baobuibk/SATELITTE_LASER_HW_1.0.0/01_DESIGN/Block_V2_Detail-LASER_DETAIL.png

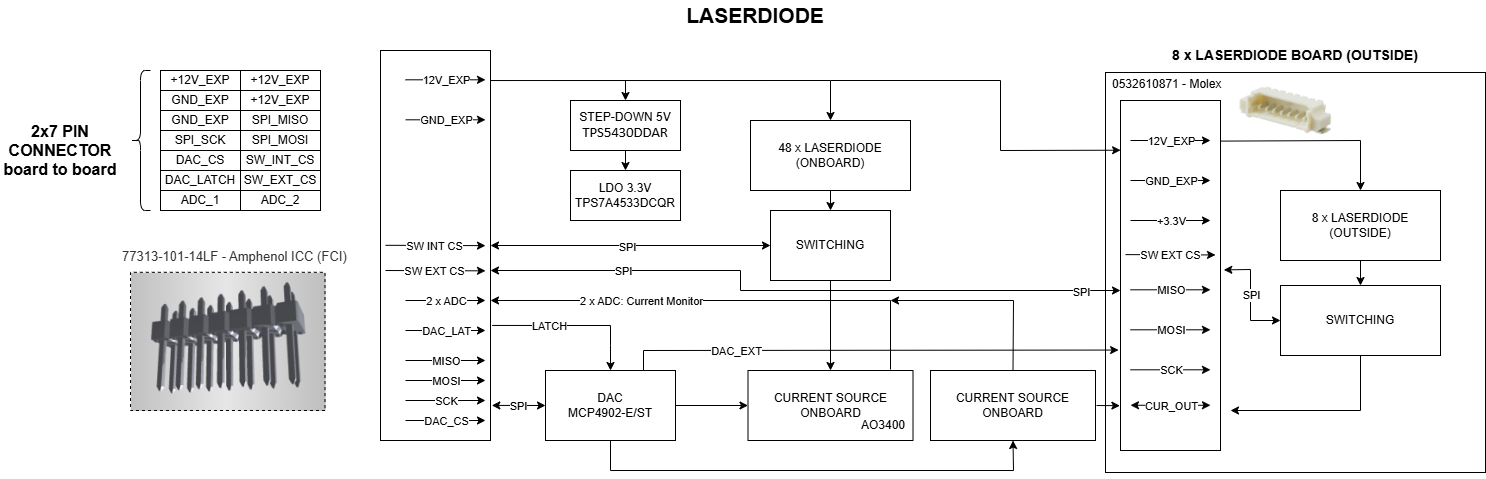
01_DESIGN/Block_V2_Detail-LASER_DETAIL.png
