baobuibk/SATELITTE_LASER_HW_1.0.0/03_BOM/NANORACK_LASER.xlsx

Name | Description | Designator | Footprint | Manufacturer 1 | Manufacturer Part Number 1 | Quantity | NOTE | STATUS
10nF/16V | CL10B103KB8NNNC | C1 | SM-0603 | Samsung Electro-Mechanics | CL10B103KB8NNNC | 1 |  | STOCK
0.22uF/25V | CL10B224KA8NNNC | C2, C3, C9, C10, C11, C12, C17, C18, C20, C21, C24, C25, C26, C30, C33, C34, C35, C36, C37, C38, C39, C40, C43, C44, C46, C47, C53, C54, C55, C56, C59, C60, C61, C62, C63, C64 | SM-0603 | Samsung Electro-Mechanics | CL10B224KA8NNNC | 36 |  | STOCK
47uF/20V | TAJC476K020RNJ | C4, C5, C6, C7, C8, C13, C14, C15, C16 | CAP TANT 2312 | KYOCERA AVX | TAJC476K020RNJ | 9 |  | ORDER
470pF/50V | CL10B471KB8NNNC | C19, C23, C27, C28, C29, C48, C49, C50 | SM-0603 | Samsung Electro-Mechanics | CL10B471KB8NNNC | 8 |  | STOCK
12pF/50V | CL10C120JB81PNC | C22, C32, C42, C45, C52, C58 | SM-0603 | Samsung Electro-Mechanics | CL10C120JB81PNC | 6 |  | STOCK
100pF/25V | C0603C101M3HACTU | C31, C41, C51, C57 | SM-0603 | KEMET | C0603C101M3HACTU | 4 |  | ORDER
SS54 | SS54 | D1 | DIO-SMD-A | Multicomp | SS54 | 1 |  | STOCK
S2303 | S2303 | D2, D3, D4, D5, D6, D7, D8, D9 | SOT23-123 | SMC Diode Solutions | S2303 | 8 |  | STOCK
1N4148W-TP | 1N4148W-TP | D10, D11, D12, D13, D14, D15, D16, D17, D18, D19, D20, D21, D22, D23, D24, D25, D26, D27, D28, D29, D30, D31, D32, D33 | SOD23 | Micro Commercial Co | 1N4148W-TP | 24 |  | STOCK
532611171 | 532611171 | J2 | MOLEX_532611171 | Molex | 53261-1171 | 1 |  | ORDER
0510211100 | CONN RCPT HSG 11POS 1.25MM |  |  | Molex | 0510211100 | 1 | Mating for J2 | ORDER
532610871 | 532610871 | J3 | MOLEX_532610001 | Molex | 53261-0871 | 1 |  | STOCK
0510210800 | CONN RCPT HSG 8POS 1.25MM |  |  | Molex | 0510210800 | 1 | Mating for J3 | STOCK
0500798000 | CONN SOCKET 26-28AWG CRIMP TIN |  |  | Molex | 0500798000 | 19 | Cos for mating J2 & J3 | STOCK
15uH/3.5A | SRP7050TA-150M | L1 | SRP7050TA | Bourns | SRP7050TA-150M | 1 |  | STOCK
10uH | MLZ1608N100LT000 | L2 | FER 0805/2012 | TDK | MLZ1608N100LT000 | 1 |  | STOCK
LaserDiode | OPV302 | LD1, LD2, LD3, LD4, LD5, LD6, LD7, LD8, LD9, LD10, LD11, LD12, LD13, LD14, LD15, LD16, LD17, LD18, LD19, LD20, LD21, LD22, LD23, LD24 | LASER_SOCKET | Optek | OPV302 | 24 |  | STOCK
DMG302PU-7 | DMG302PU-7 | Q1, Q3 | SOT23-3-132 | Diodes Inc. | DMG302PU-7 | 2 |  | ORDER
DMG301NU-7 | DMG301NU-7 | Q2, Q4 | SOT23-3-132 | Diodes Inc. | DMG301NU-7 | 2 |  | ORDER
10K/1% | ERJ-3EKF1002V | R1 | RES-SMD-0603 | Panasonic | ERJ-3EKF1002V | 1 |  | STOCK
3.24K 0.1% | ERJ-3EKF3241V | R2 | RES-SMD-0603 | Panasonic | ERJ-3EKF3241V | 1 |  | STOCK
300R/0.1% | RT0603BRC07300RL | R3 | RES_SMD_0603_SHUNT | Yageo Group | RT0603BRC07300RL | 1 |  | ORDER
30K/0.1% | ERA-3AEB303V | R4, R21 | RES-SMD-0603 | Panasonic | ERA-3AEB303V | 2 |  | ORDER
51R/1% | ERJ-3EKF51R0V | R6, R17, R22, R31 | RES-SMD-0603 | Panasonic | ERJ-3EKF51R0V | 4 |  | STOCK
1K/1% | ERJ-3EKF1001V | R7, R8, R9, R15, R18, R19, R23, R24, R25, R29, R32, R33 | RES-SMD-0603 | Panasonic | ERJ-3EKF1001V | 12 |  | STOCK
100R/1% | ERJ-PA3D1000V | R10, R11, R14, R26, R27, R28 | RES-SMD-0603 | Panasonic | ERJ-PA3D1000V | 6 |  | ORDER
4.7K/1% | ERJ-3EKF4701V | R5, R12, R13, R34, R35, R36, R37, R38, R39 | RES-SMD-0603 | Panasonic | ERJ-3EKF4701V | 9 |  | STOCK
20K/0.1% | ERA-3AEB203V | R16, R30 | RES-SMD-0603 | Panasonic | ERA-3AEB203V | 2 |  | ORDER
75R/0.1% | TNPW060375R0BEEA | R20 | RES_SMD_0603_SHUNT | Vishay | TNPW060375R0BEEA | 1 |  | ORDER
TPS5430DDAR | TPS5430DDAR | U1 | HSOP8 | Texas Instruments | TPS5430DDAR | 1 |  | STOCK
TPS7A4533DCQR | TPS7A4533DCQR | U2 | SOT223-6 | Texas Instruments | TPS7A4533DCQR | 1 |  | STOCK
MCP4902-E/ST | MCP4902-E/ST | U3 | TSSOP14 | Microchip | MCP4902-E/ST | 1 |  | ORDER
INA139 | INA139NA/250 | U4, U6 | SOT23-5 | Texas Instruments | INA139NA/250 | 2 |  | ORDER
OPA2192 | OPA2192IDR | U5, U7 | SO8 | Texas Instruments | OPA2192IDR | 2 |  | ORDER
ADG1414BRUZ | ADG1414BRUZ | U8, U9, U10 | TSSOP24 | Analog Devices | ADG1414BRUZ | 3 |  | STOCK
Custom Socket Laser | CONN PIN RCPT .015-.022 SOLDER |  |  | Mill-Max Manufacturing Corp. | 0461-1-15-15-21-27-04-0 | 144 | Note:(4 x (24 + 12)) | STOCK
 |  |  |  |  | Total | 178
