baobuibk/SATELITTE_LASER_HW_1.0.0/02_SCHEMATIC_PDF/NANORACK_LASER_V130.pdf

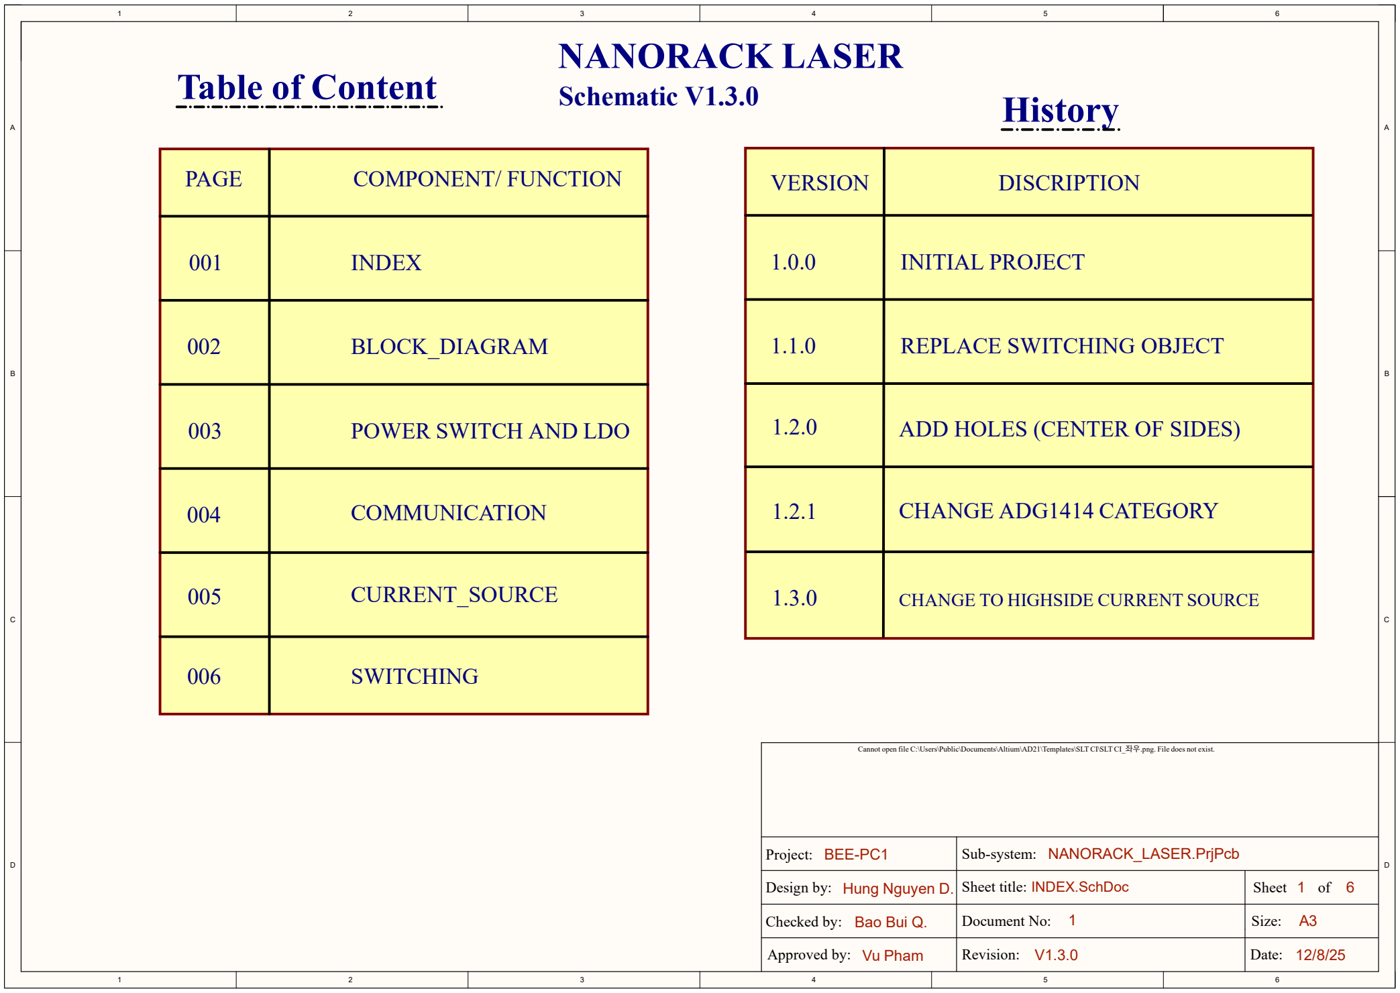
[picture p2: figure]
Table of Content; PAGE; COMPONENT/ FUNCTION; INDEX; BLOCK_DIAGRAM; POWER SWITCH AND LDO; COMMUNICATION; CURRENT_SOURCE; SWITCHING; NANORACK LASER; Schematic V1.3.0; History; VERSION; DISCRIPTION; INITIAL PROJECT; REPLACE SWITCHING OBJECT; 1.2.0 ADD HOLES (CENTER OF SIDES); 1.2.1 CHANGE ADG1414 CATEGORY; 1.3.0 CHANGE TO HIGHSIDE CURRENT SOURCE

Cannot open file C:\Users\Public\Documents\Altium\AD21\Templates\SLT CI\SLT CI_좌우.png. File does not exist.

Project: BEE-PC1 | Sub-system: NANORACK_LASER.PrjPcb
Design by: Hung Nguyen D. | Sheet title: INDEX.SchDoc | Sheet 1 6 of
Checked by: Bao Bui Q. | Document No: | Size: A3
Approved by: Vu Pham | Revision: V1.3.0 | Date: 12/8/25

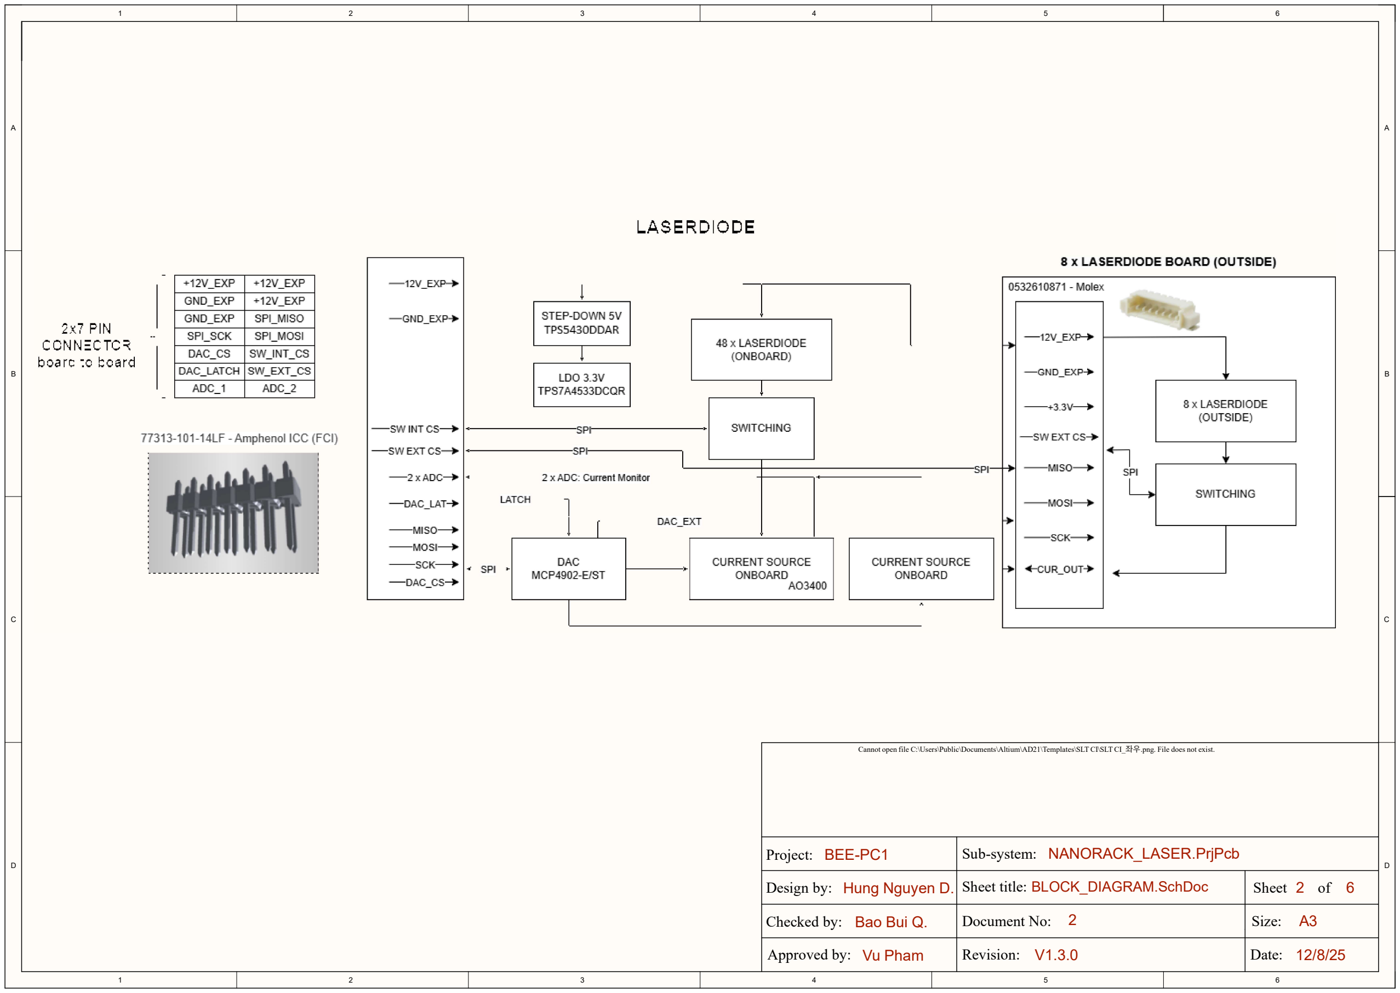
[picture p3: page 2]

D D

C C

B B

A A

# Date: 12/8/25

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

Project: BEE-PC1 | Sub-system: NANORACK_LASER.PrjPcb
Design by: Hung Nguyen D. | Sheet title: BLOCK_DIAGRAM.SchDoc | Sheet 2 6 of

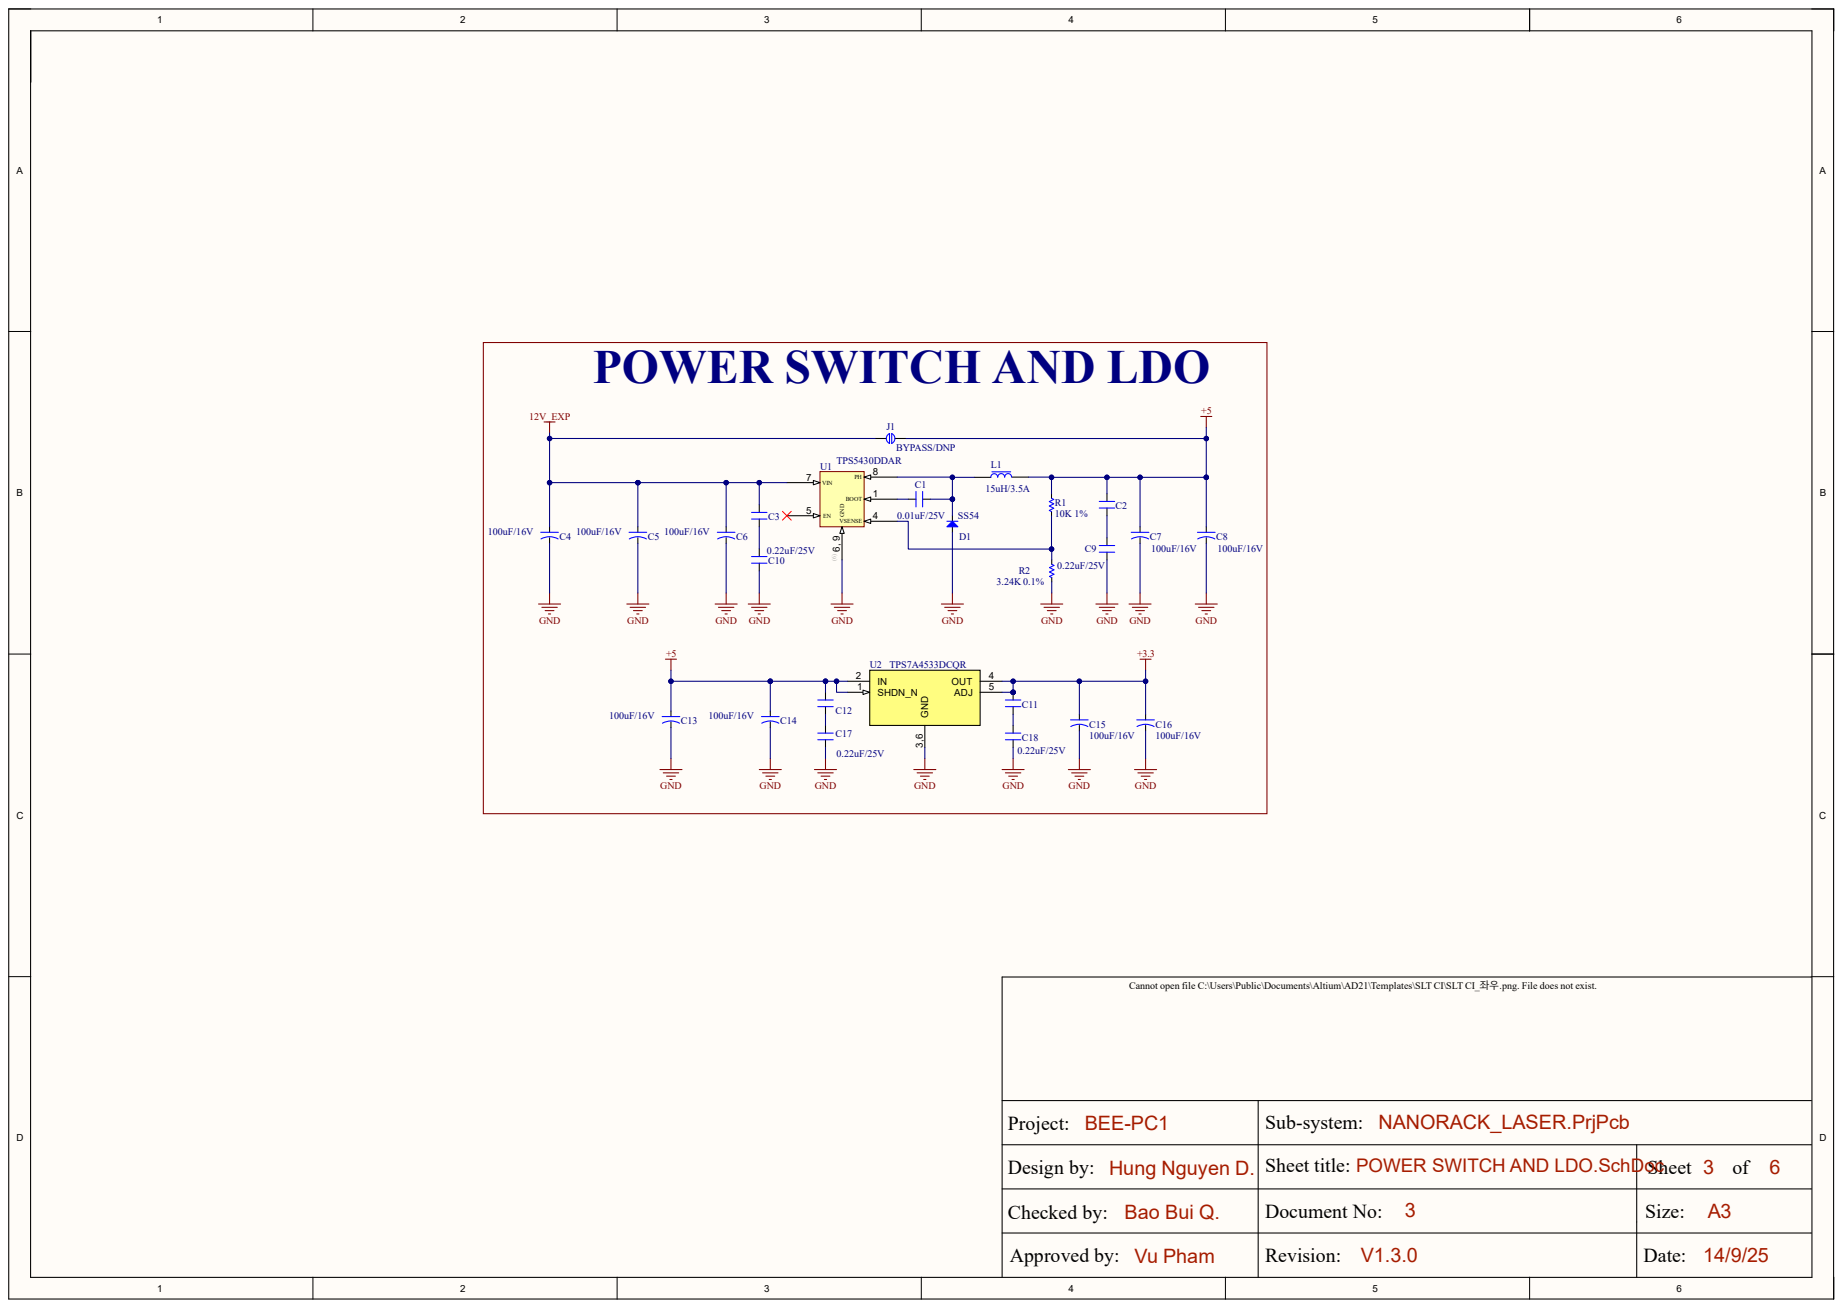
[picture p4: page 3]

POWER SWITCH AND LDO

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

Project: BEE-PC1 | Sub-system: NANORACK_LASER.PrjPcb

Design by: Hung Nguyen D. | Sheet title: POWER SWITCH AND LDO.SchDoc | Sheet 3 6 of

# BOARD TO BOARD CONNECTOR TO EXP BOARD

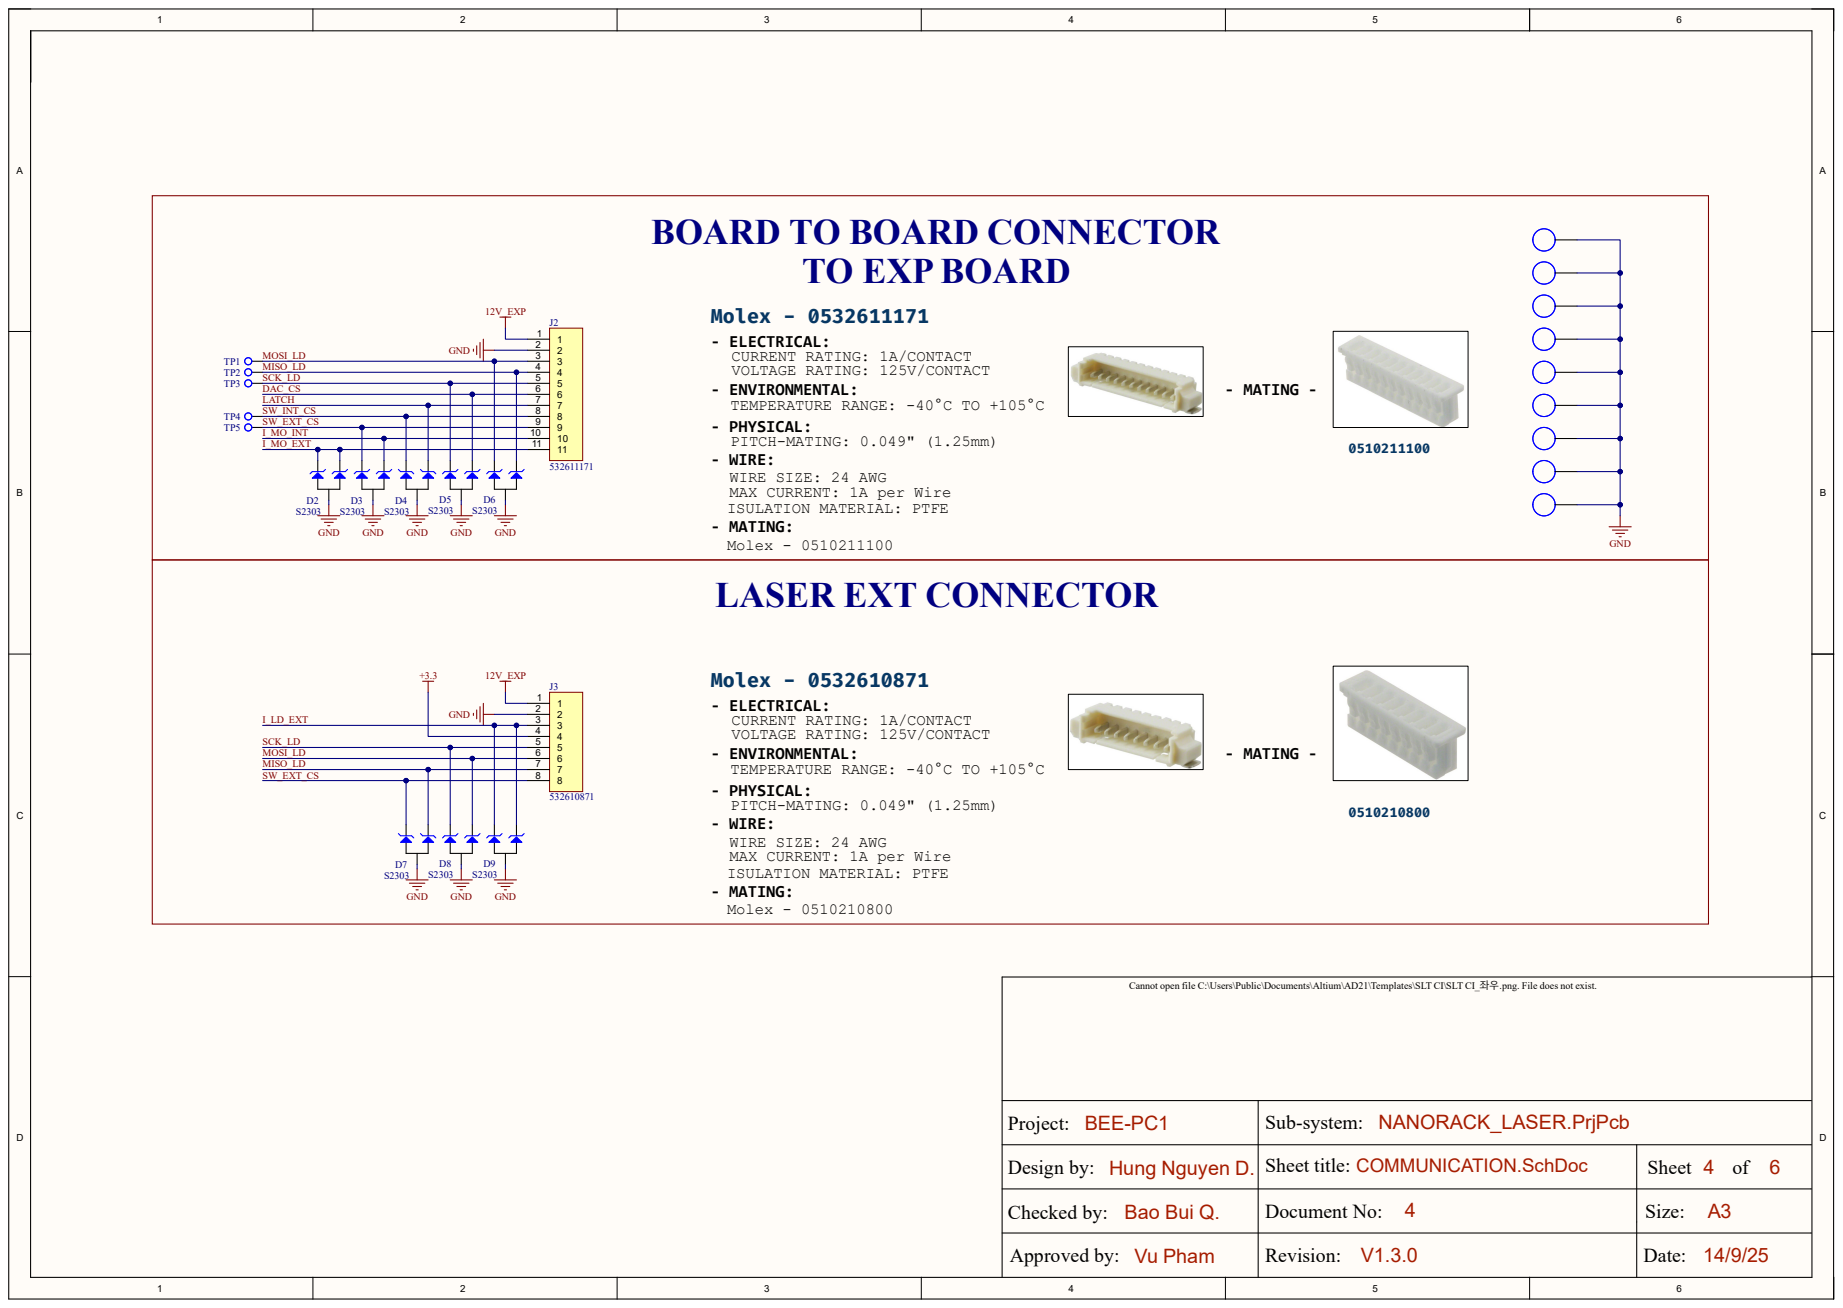
[picture p5: page 4]

Molex - 0532611171
- ELECTRICAL:
CURRENT RATING: 1A/CONTACT
VOLTAGE RATING: 125V/CONTACT
- ENVIRONMENTAL:
TEMPERATURE RANGE: -40°C TO +105°C
- PHYSICAL:
PITCH-MATING: 0.049" (1.25mm)
- WIRE:
WIRE SIZE: 24 AWG
MAX CURRENT: 1A per Wire
ISULATION MATERIAL: PTFE
- MATING:
LASER EXT CONNECTOR

Molex - 0532610871
Molex - 0510210800

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

Project: BEE-PC1 | Sub-system: NANORACK_LASER.PrjPcb

Design by: Hung Nguyen D. | Sheet title: COMMUNICATION.SchDoc | Sheet 4 6 of

# DRIVER_INT

# I_LDmax = 30mA, Choose VDACmax = 3V -> R8 = 100R

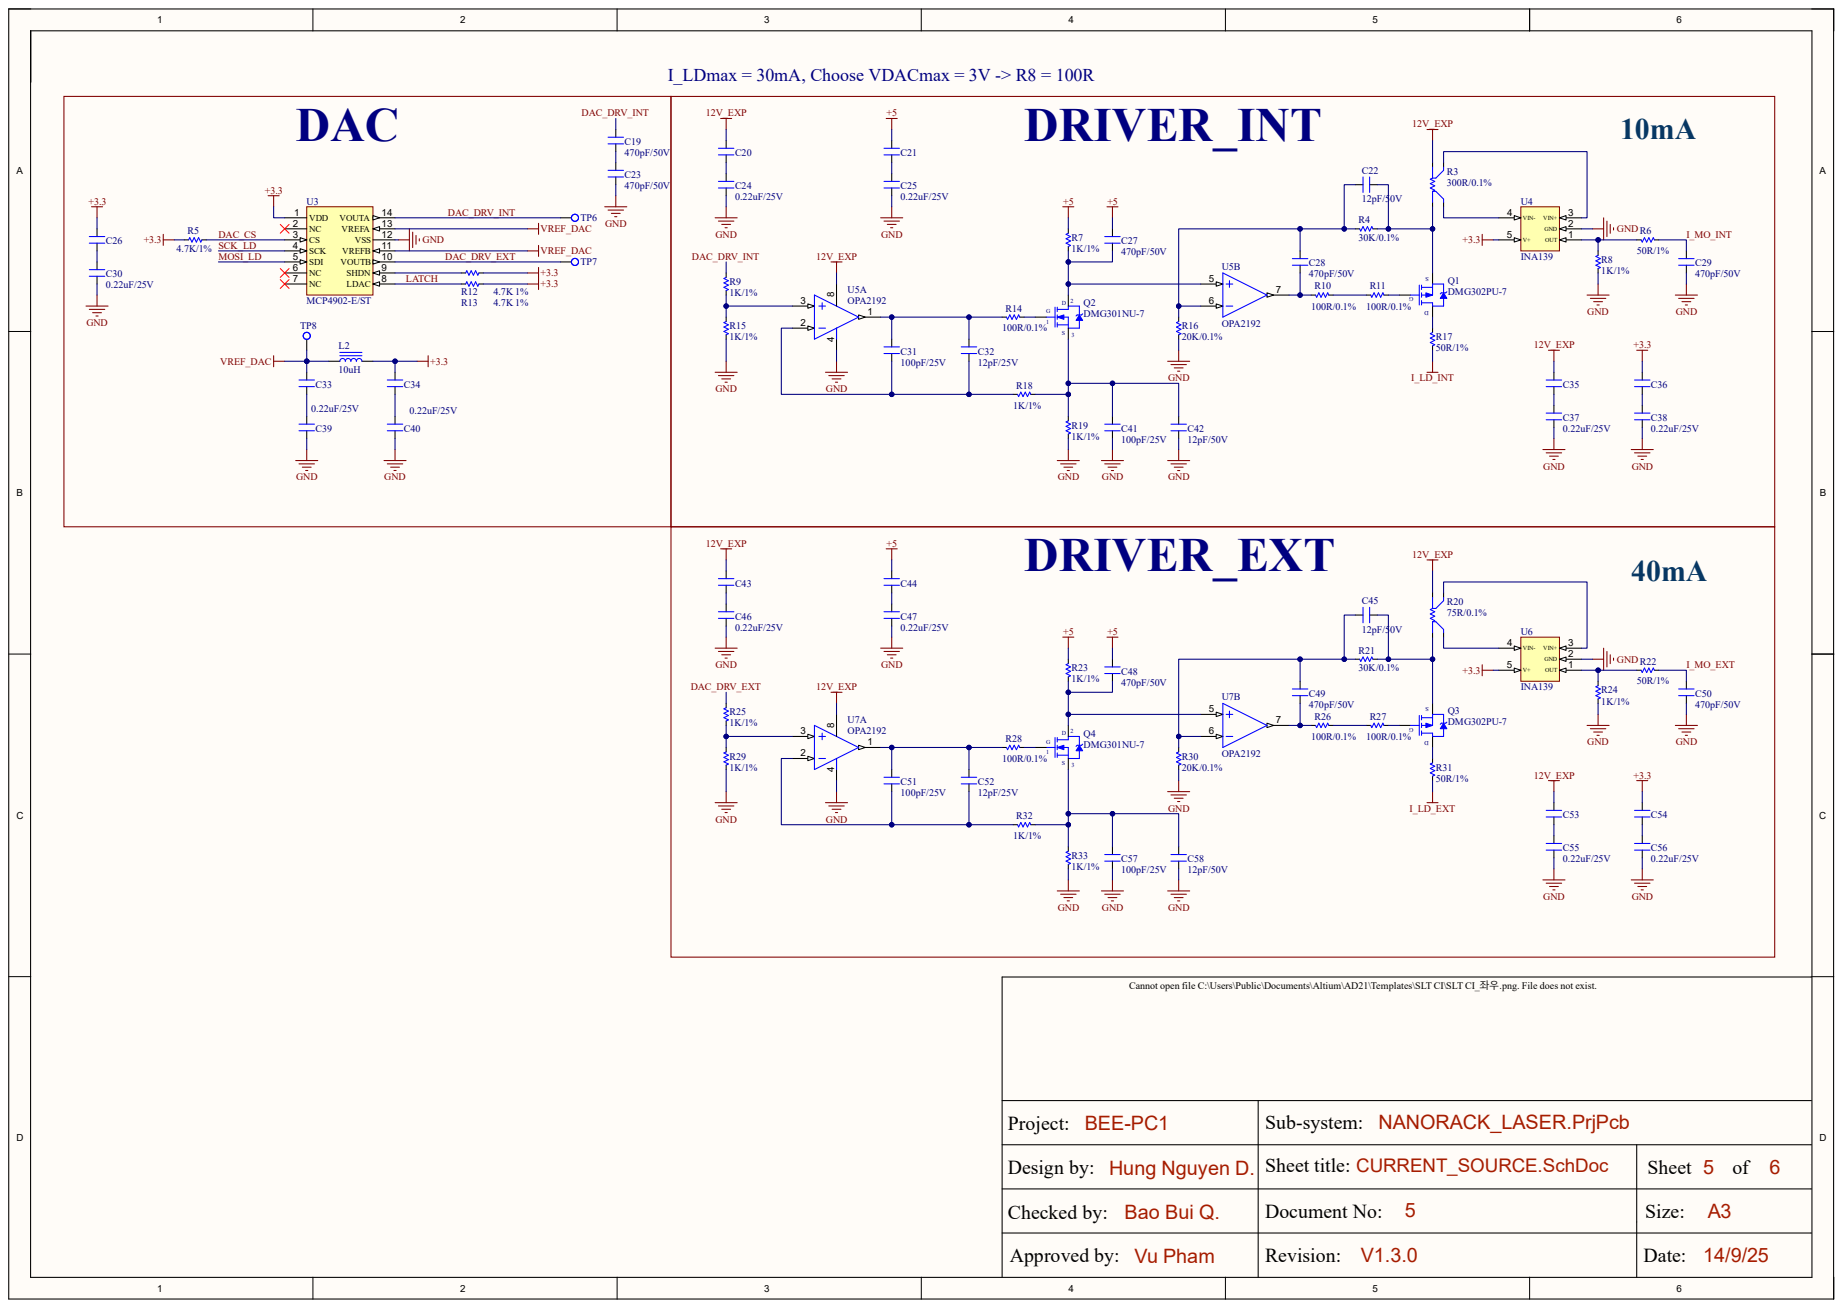
[picture p6: page 5]

VOUTB 10 VREFB 11 VSS 12 VREFA 13 VOUTA 14

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

Project: BEE-PC1 | Sub-system: NANORACK_LASER.PrjPcb

Design by: Hung Nguyen D. | Sheet title: CURRENT_SOURCE.SchDoc | Sheet 5 6 of

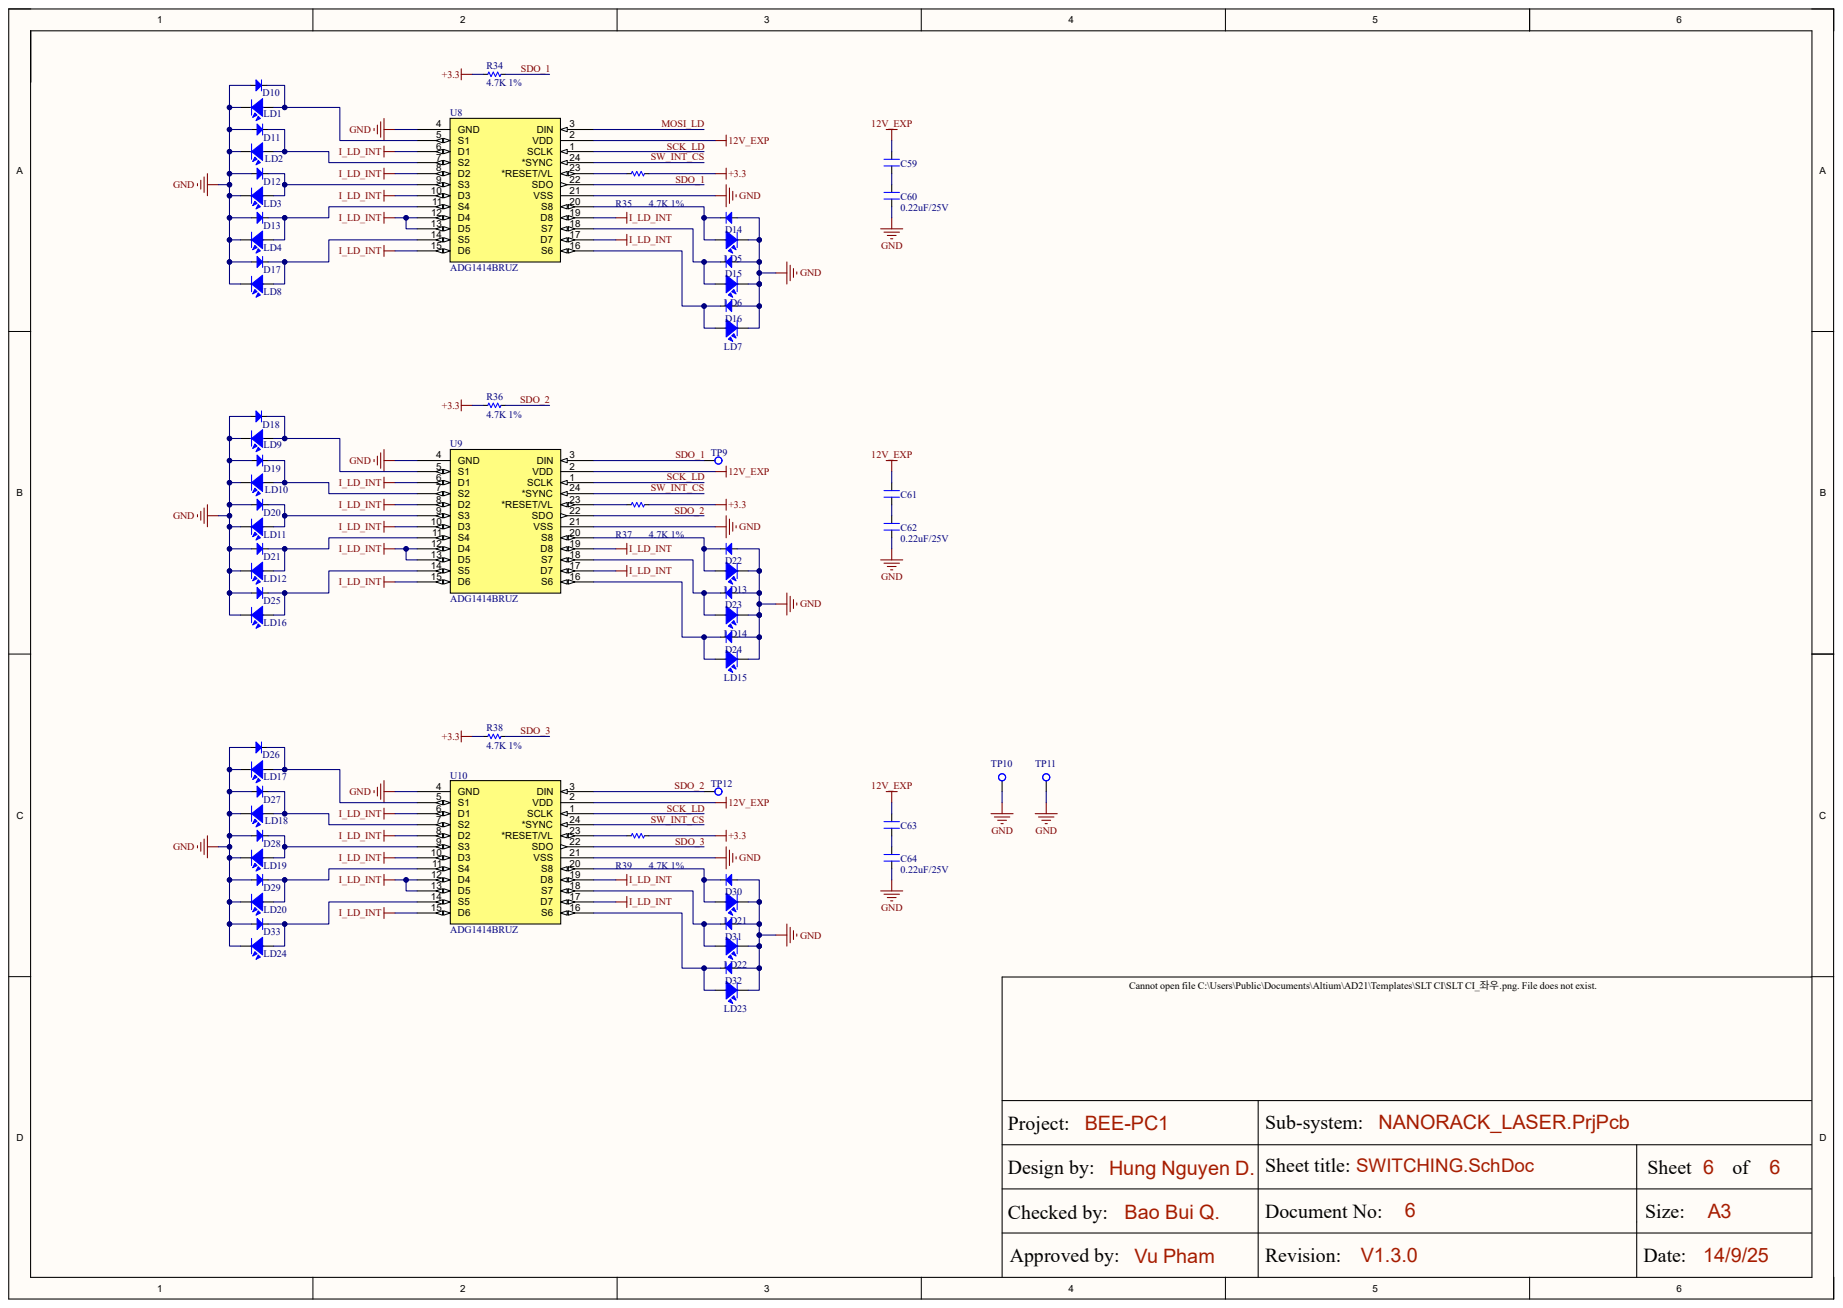
[picture p7: page 6]
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

Project: BEE-PC1 | Sub-system: NANORACK_LASER.PrjPcb

Design by: Hung Nguyen D. | Sheet title: SWITCHING.SchDoc | Sheet 6 6 of
