baobuibk/SATELITTE_LASER_HW_1.0.0/05_SMT/ASM_NANORACK_LASER_V130.pdf

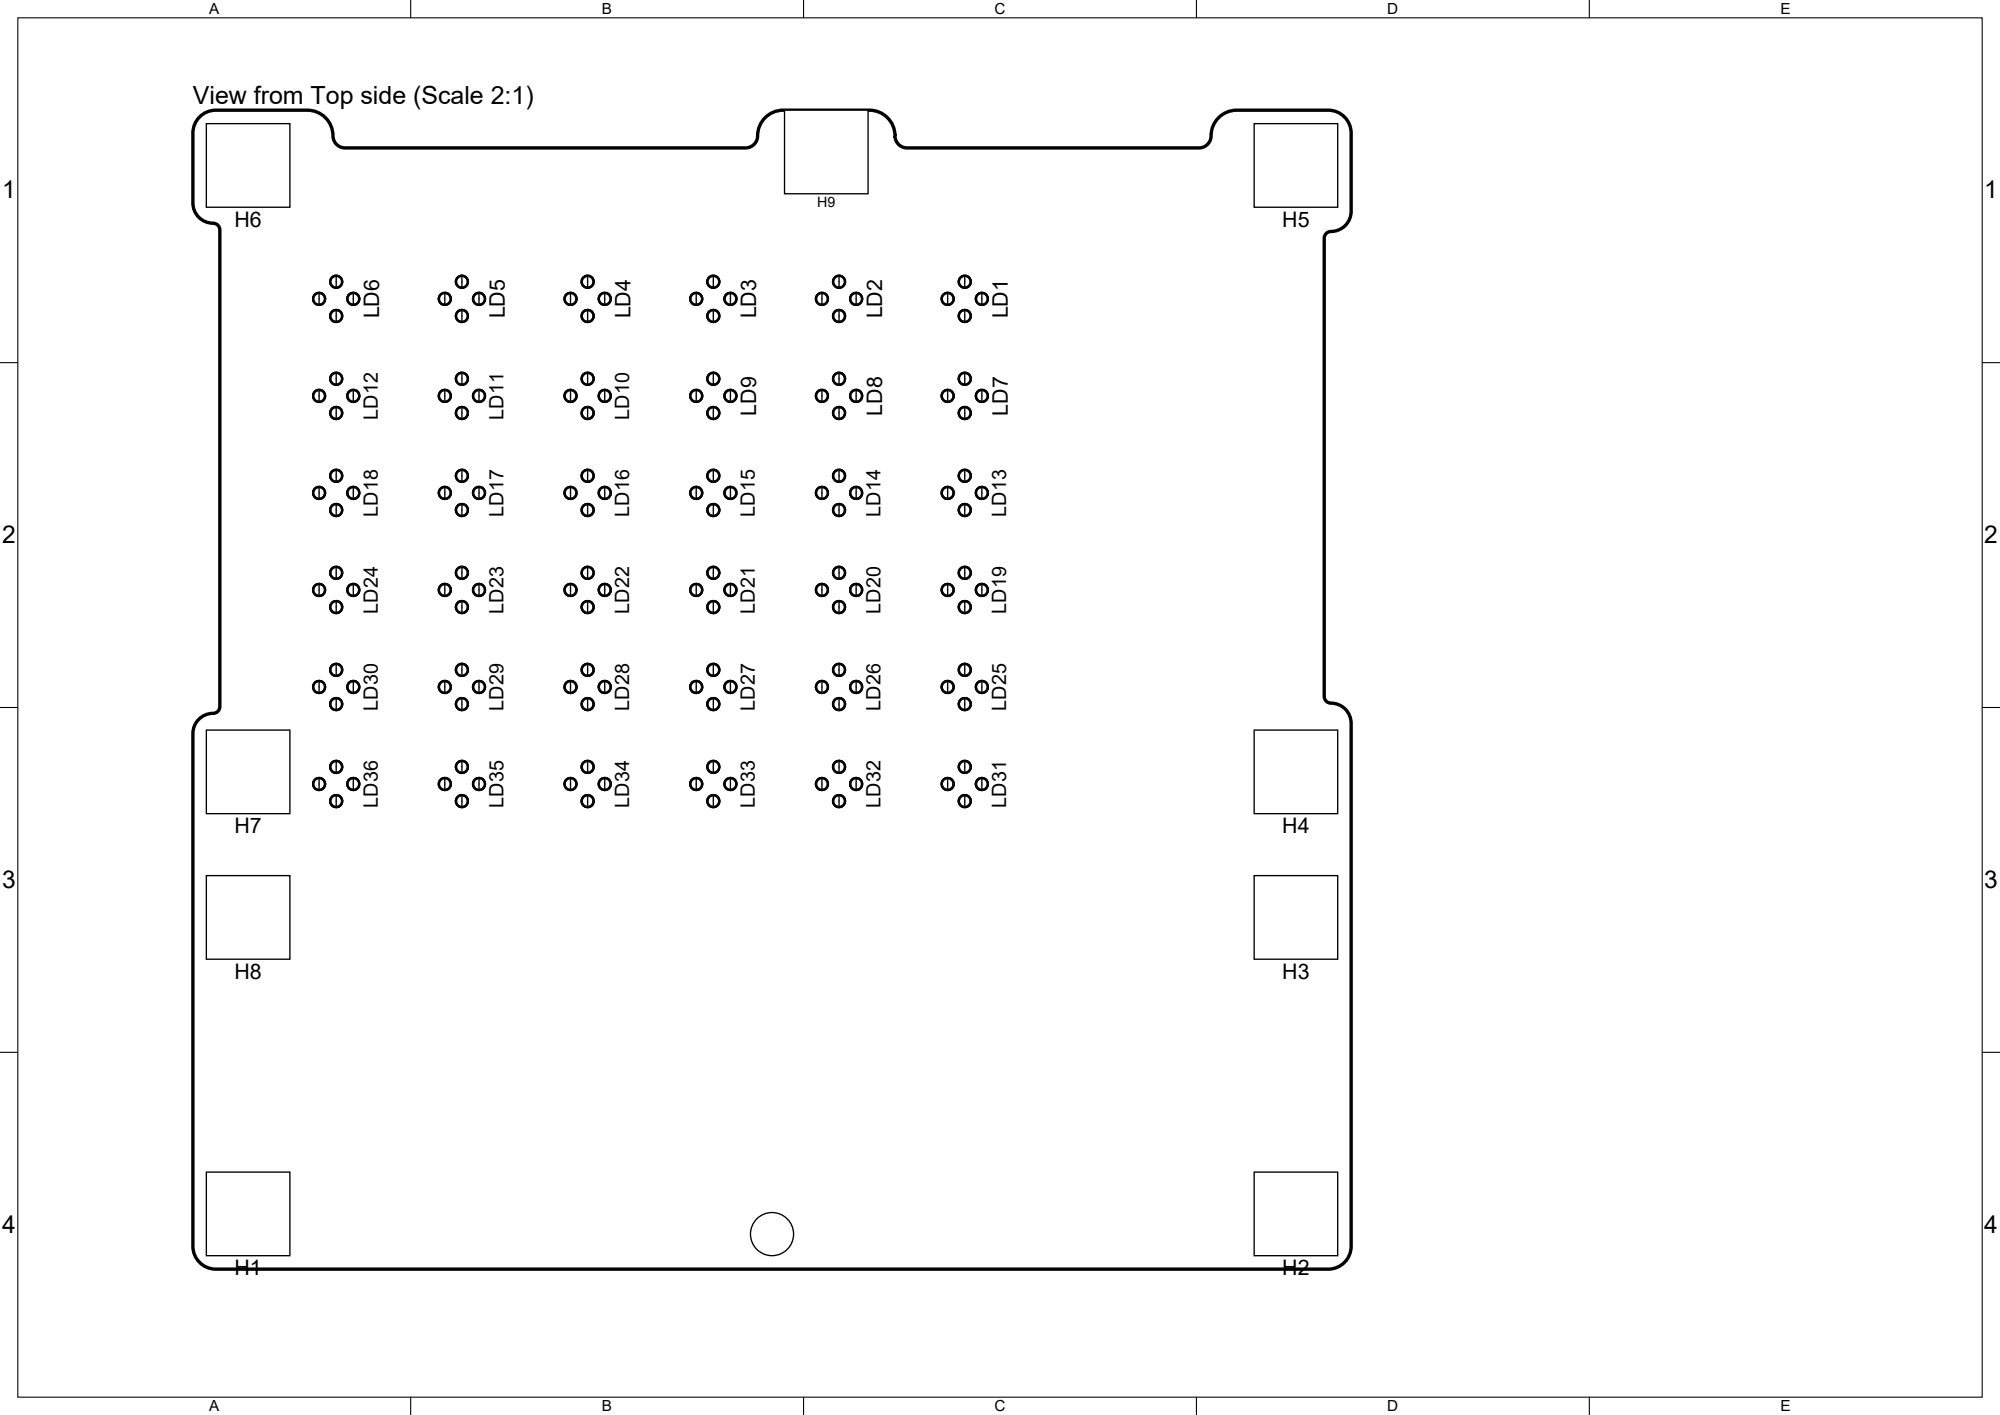
[picture p8: page 1]

View from Top side (Scale 2:1)

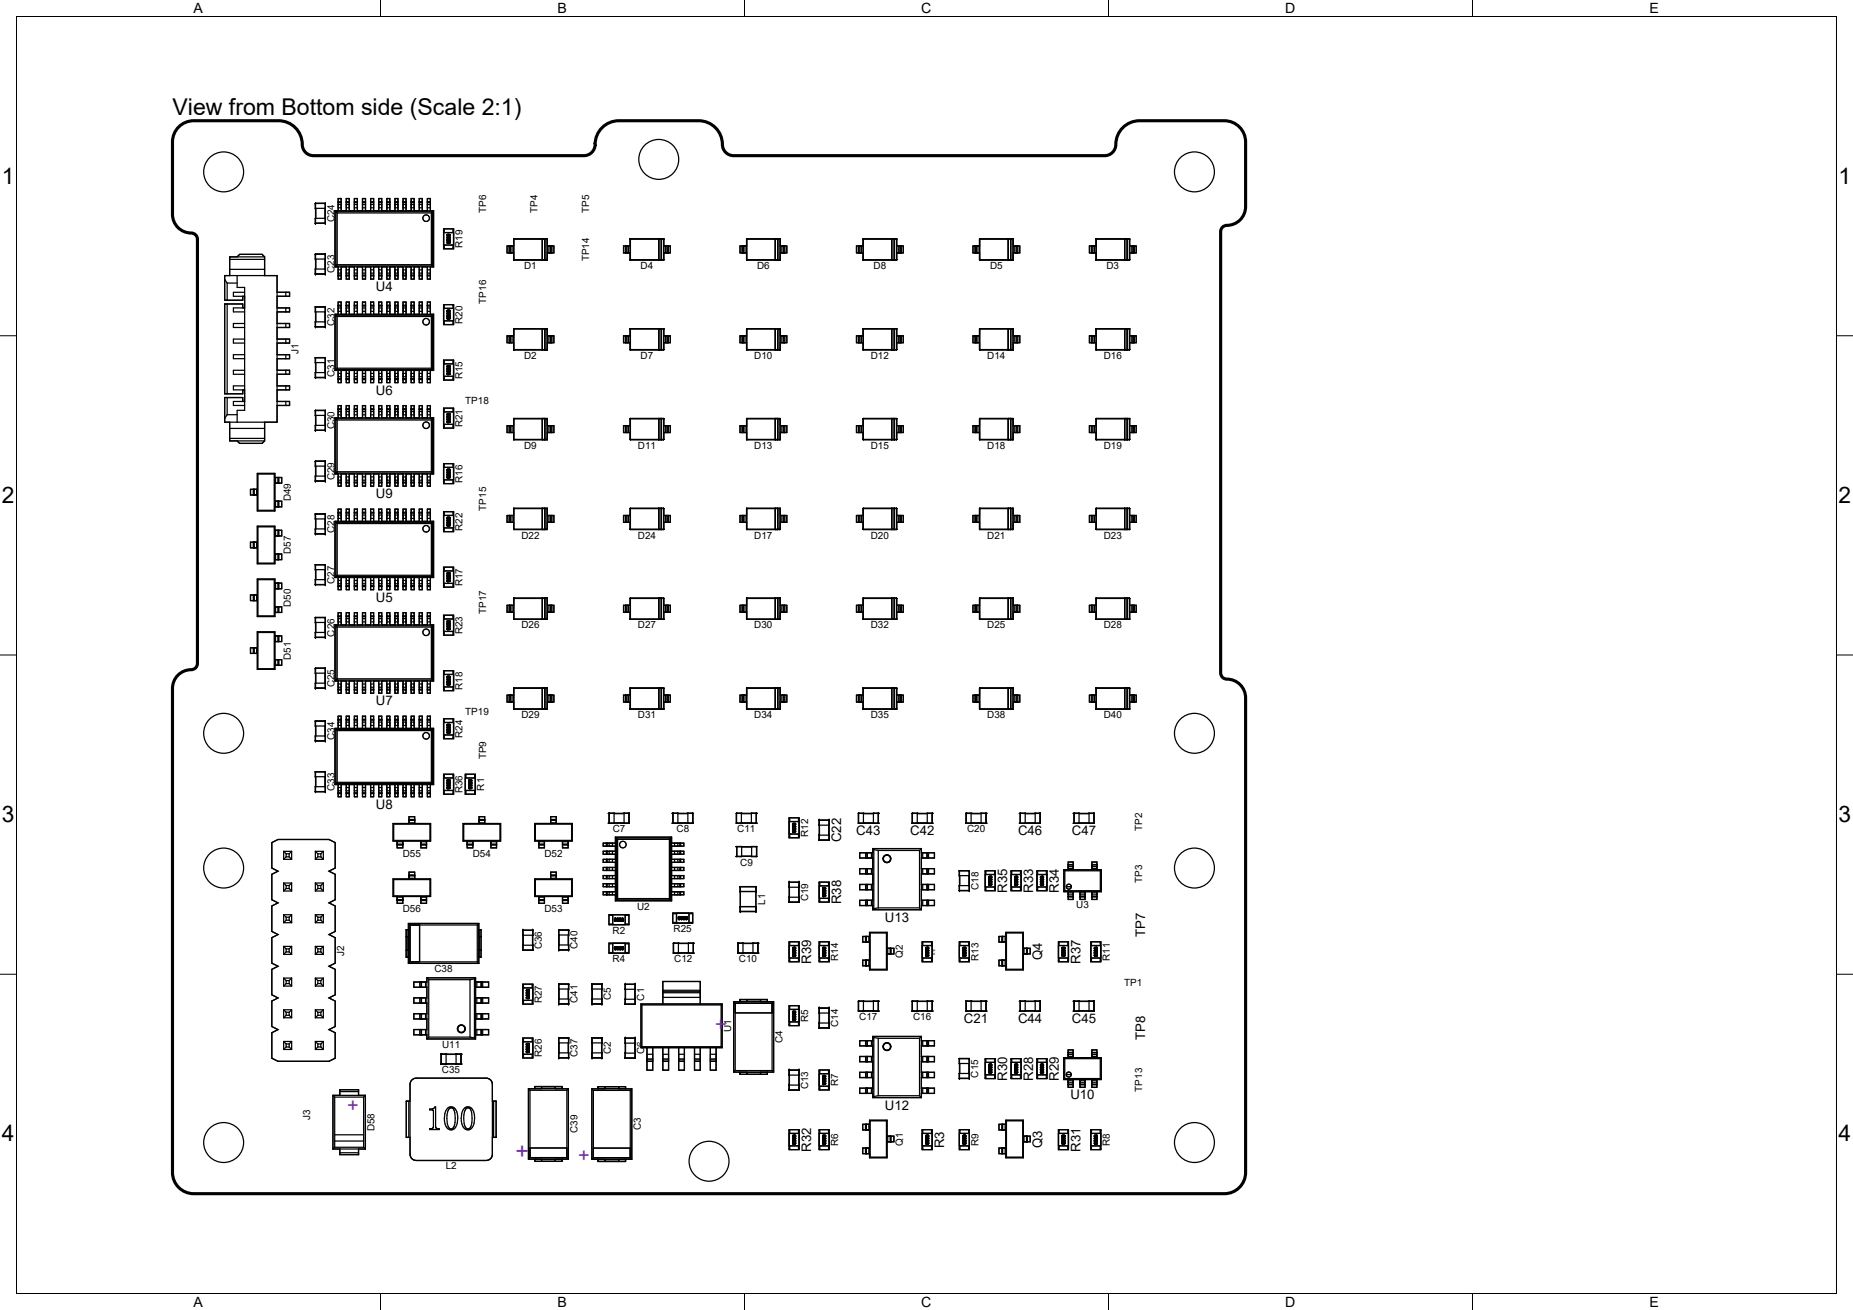
[picture p9: page 2]

View from Bottom side (Scale 2:1)+
