baobuibk/SATELITTE_LASER_HW_1.0.0/(list of files, drawings)

Other design files:
01_DESIGN/BLOCK_DIAGRAM.SchDoc
01_DESIGN/COMMUNICATION.SchDoc
01_DESIGN/CURRENT_SOURCE.SchDoc
01_DESIGN/INDEX.SchDoc
01_DESIGN/NANORACK_LASER.PrjPcb
01_DESIGN/POWER SWITCH AND LDO.SchDoc
01_DESIGN/SWITCHING.SchDoc
