baobuibk/SATELITTE_LASER_HW_1.0.0/(commit log)

2025-09-14 first commit and final design ver of 1.3.0
    [BLOCK_DIAGRAM.SchDoc, COMMUNICATION.SchDoc, CURRENT_SOURCE.SchDoc, INDEX.SchDoc, LASERDIODE_BOM_V1.3.0.xlsx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]
2025-09-14 update sche pdf, gerber, 3d and design
    [COMMUNICATION.SchDoc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]
2025-09-15 update pcb design and gerber
    [LASERDIODE_V1.3.0_Copper_Signal_1.gbr, LASERDIODE_V1.3.0_Copper_Signal_2.gbr, LASERDIODE_V1.3.0_Copper_Signal_Bot.gbr, LASERDIODE_V1.3.0_Copper_Signal_Top.gbr, LASERDIODE_V1.3.0_Legend_Bot.gbr, LASERDIODE_V1.3.0_Legend_Top.gbr, LASERDIODE_V1.3.0_Pads_Bot.gbr, LASERDIODE_V1.3.0_Pads_Top.gbr]
2025-09-15 update board stack layer excel
    [COMMUNICATION.SchDoc, CURRENT_SOURCE.SchDoc, LASERDIODE_V1.3.0.xls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]
2025-09-15 update gerber to fix no soldermask for j2 and j3
    [CURRENT_SOURCE.SchDoc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]
2025-09-16 update step 3d file
    [CURRENT_SOURCE.SchDoc, LASERDIODE_BOM_V1.3.0.xlsx, NANORACK_LASER.PrjPcb, NANORACK_LASER.xlsx, SWITCHING.SchDoc]
